SashaLag/Dorothy/ControlloMotori/Pololu - TB6612FNG Dual Motor Driver Carrier_files/0J4617.600x480.jpg

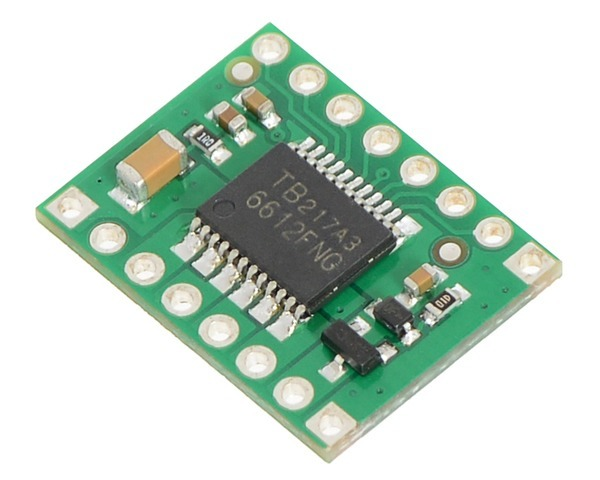
ControlloMotori/Pololu - TB6612FNG Dual Motor Driver Carrier_files/0J4617.600x480.jpg
