SashaLag/Dorothy/Report/Report Dorothy.pdf

## Progetto del veicolo a guida indoor autonoma Dorothy

Facoltà di Ingegneria dell’Informazione, Informatica e Statistica

Corso di Laurea Magistrale in Ingegneria Elettronica

Marco Balsi,

## Laboratorio II - Multidisciplinare

Alessandro Dei Giudici, 1398361 Pierpaolo Granello 1571747

Anno Accademico 2017/2018

Progetto del veicolo a guida indoor autonoma Dorothy

## Laboratotio Multidisciplinare II - Marco Balsi. Sapienza – Università di Roma

© 2018 Alessandro Dei Giudici, Pierpaolo Granello. Tutti i diritti riservati

Questa relazione è stata composta con LATEX e la classe Sapthesis.

Versione: 27 maggio 2018

Email dell’autore: deigiudici.1398361@studenti.uniroma1.it, granello.1571747@studenti.uniroma1.it

ii

# Indice

1 Introduzione | 1
2 Creazione delle specifiche | 2
3 List of Components | 6
4 Verifica e validazione | 13

1

# Capitolo 1

# Introduzione

Lo scopo del presente progetto è quello di simulare lo sviluppo di un veicolo a guida indoor autonoma in base alle specifiche fornite da un ipotetico committente. A partire dalle richieste espresse da quest’ultimo, in linguaggio poco tecnico e a volte parziale (User Needs), sono state formulate specifiche più tecniche e dettagliate (User Requirements). In questa fase, vengono elaborate le richieste dell’utente al fine di ottenere caratteristiche tecniche del dispositivo che l’utente può aver omesso o non considerato affatto; devono, di conseguenza, essere complete, chiare, tracciabili (deve esserci un collegamento chiaro tra esigenze e requisiti) e non ridondanti (non ce ne devono essere di più di quelli richieste).
Superata questa fase si passa allo sviluppo tecnico dove il committente non partecipa e per questo si redige una relazione sullo sviluppo delle specifiche tecniche e delle specifiche dei componenti. Le prime (System Specification) descrivono detta-gliamente il dispositivo che verrà progettato, le seconde (Component Specifications) descrivono le caratteristiche dei singoli componenti necessari per la realizzazione effettiva del prototipo. Entrambe le specifiche devono anche qui presentare gli stessi attributi di completezza, tracciabilità e non ridondanza come descritto in precedenza per gli User Requirements.
Al fine di verificare il rispetto delle specifiche stilate sono stati sviluppati dei codici di test (Verifica e validazione). L’ultima fase è stata quindi quella della realizzazione fisica del dispositivo.

2

# Capitolo 2

# Creazione delle specifiche

## 2.1 User Needs

Di seguito verranno riportate le specifiche richieste inizialmente dall’utente:

- UN1 - veicolo autonomo capace di navigare in un ambiente indoor sconosciuto
- UN2 - piccolo veicolo che si muove in modo autonomo scegliendo il percorso più libero in un raggio di 10m tenendo conto di oggetti anche piccoli a diverse altezze
- UN3 - se urta un ostacolo deve fermarsi
- UN4 - velocità media almeno 0.2m/s, autonomia almeno 10’
- UN5 - visualizzare su un terminale remoto le misure acquisite
- UN6 - il prezzo del sistema non deve eccedere 300€

## 2.2 User Requirements

A partire dalle specifiche comunicate dall’utente sono stati elaborati i seguenti requisiti:

- UR01 – veicolo di dimensioni massime non oltre i 25cm, capace di portare un carico (payload) di 100g, muovendosi su una superficie liscia in ambiente occupato da oggetti artificiali.
- UR02 – il veicolo deve esplorare l’ambiente percorrendo una direzione libera nei suoi dintorni, mantenendo la stessa direzione finché è possibile senza collidere con ostacoli, e cambiando direzione quando non può procedere oltre.
- UR03 – I sensori devono poter riconoscere la presenza di un ostacolo fino a 10m di distanza con una accuratezza trasversale di 5cm a 1m di distanza, valutandone la posizione verticale con accuratezza di 10cm
- UR04 – Il carrello deve potersi muovere in modo da mantenere una velocità media di almeno 0.2m/s

2.3 System Specification | 3
- UR05 – L’autonomia di funzionamento deve essere di almeno 10’
- UR06 – Trasferire le misure acquisite attraverso connessione senza fili verso un computer remoto per visualizzarle
- UR07 – In caso di urto frontale il veicolo deve fermarsi immediatamente e cercando un nuovo percorso libero come per la UR02
- UR08 – Il prezzo del sistema (con riferimento all’ordine di 1000 pezzi) non deve eccedere 300€

Di seguito si riporta la matrice di tracciabilità tra esigenze di utente e requisiti di sistema:

Tabella 2.1. Matrice di tracciabilità tra esigenze di utente e requisiti di utente

UN01 | UN02 | UN03 | UN04 | UN05 | UN06

UR01
UR02
UR03
UR04
UR05
UR06
UR07
UR08

## 2.3 System Specification

A partire dalle specifiche concordate con il cliente, sono state formulate le seguenti specifiche di sistema:

- SS01 - veicolo di diametro non oltre i 25cm, capace di portare un carico (payload) di 100g, muovendosi su una superficie liscia
- SS02 – il sistema di controllo utilizza osservazioni provenienti da opportuni sensori per determinare lo spazio libero per il movimento
- SS03 - il sistema di controllo muove il veicolo in direzione rettilinea per almeno 1m purché le misure ottenute dai sensori indichino che c’è spazio sufficiente coerentemente con il movimento programmato fino alla successiva lettura dei sensori stessi
- SS04 – se le misure ottenute dai sensori indicano che non c’è spazio sufficiente per proseguire nella stessa direzione, il sistema di controllo programma una rotazione di 45° e effettua un nuovo tentativo di procedere in avanti
- SS05 - In caso di ostacolo frontalmente, il veicolo compie una rotazione sul posto a passo di 45° con direzione decisa in base ai dati acquisiti precedentemente dal LiDAR ed esegue nuovamente la scansione. Se la ricerca fallisce per 8 volte consecutive (un giro completo), si arresta a meno di un segnale di reset.

2.3 System Specification | 4
- SS06 – I sensori devono poter osservare oggetti artificiali fino a 10 m di distanza
- SS07 – I sensori devono acquisire misure di distanza eseguendo un campiona-mento in azimuth con risoluzione angolare non eccedente 2.5° [atn(0.05/1)] nell’ambito di un angolo complessivo di 45°
- SS08 – I sensori devono acquisire misure di distanza eseguendo un campio-namento in elevazione con risoluzione angolare non eccedente 5° [atn(0.1/1)] nell’ambito di un angolo complessivo di 25°
- SS09 – Il veicolo deve poter mantenere una velocità media (su 30”) di almeno 0.2m/s, tenendo conto di eventuali fermate non superiori a 2", necessarie per l’osservazione dell’ambiente
- SS10 – Il veicolo deve essere dotato di un sensore di contatto frontale e il sistema di controllo deve reagire immediatamente in caso di contatto bloccando i motori fino a individuare un percorso libero coerentemente a SS05
- SS11 - Il sistema deve essere dotato di una connessione radio per dati capace di trasferire una quantità di misure pari a quelle acquisite in base a SS07 e SS08. Il computer remoto deve essere dotato di software per acquisizione e visualizzazione delle misure
- SS12 – Il sistema deve avere una riserva di energia sufficiente per 10’ di funzionamento
- SS13 – Il costo totale dei componenti non deve eccedere 150€

Tabella 2.2. Matrice di tracciabilità tra requisiti dell’utente e specifiche di sistema

UR01 | UR02 | UR03 | UR04 | UR05 | UR06 | UR07 | UR08

SS01
SS02
SS03
SS04
SS05
SS06
SS07
SS08
SS09
SS10
SS11
SS12
SS13

2.4 Component Specificications | 5

## 2.4 Component Specificications

A partire dalle specifiche di sistema sono state stilate le seguenti specifiche sui componenti acquistati:

- SC01 - veicolo di diametro non oltre i 25cm, capace di portare un carico (payload) di 100g, dotato di due ruote motrici più una libera oppure di due cingoli indipendenti, azionati da due motori elettrici in grado di garantire una velocità media di 0.2m/s
- SC02 - I sensori di contatto sono realizzati con 2 semplici switch in pulldown montati frontalmente al veicolo
- SC03 - Il sensore per ostacoli è costituito da un LiDAR, montato su una coppia di servo opportunamente articolati, e da due switch per l’arresto immediato del veicolo in caso di urto con un oggetto
- SC04 - La movimentazione del servo sul piano orizzontale prevede almeno 19 punti, spaziati di 2.5° da -22.5° a +22.5° rispetto alla direzione frontale
- SC05 - La movimentazione del servo sul piano verticale prevede almeno 6 punti, spaziati di 5° da 0° a +25° rispetto alla direzione frontale
- SC06 - Ad ogni sosta il LiDAR esegue una scansione completa (19x6 punti) e prende una decisione sul successivo spostamento del veicolo in meno di 2"
- SC07¹
- La connessione wireless è implementata utilizzando un trasmettitore ed un ricevitore radio funzionanti a 433 MHz.

Tabella 2.3. Matrice di tracciabilità tra specifiche dei componenti e specifiche di sistema

SC01 | SC02 | SC03 | SC04 | SC05 | SC06 | SC07

SS01
SS02
SS03
SS04
SS05
SS06
SS07
SS08
SS09
SS10
SS11
SS12
SS13

1
In seguito ad una succeccissiva discussione con l’utente in merito alla SC07, si è concordato di elidere la richiesta UN5, date le difficoltà della sua implementazione. Conseguentemente si trascura la specifica di sistema SS11 nella realizzazione del veicolo.

6

# Capitolo 3

# List of Components

Per la costruzione del veicolo progettato, il seguente è un elenco dei componenti necessari per la sua realizzazione:

- Arduino Uno R3,
- Kit Chassis 2 ruote,
- Driver PWM per motori Pololu - TB6612FNG,
- Benewake TFMINI Micro LiDAR Module (12 m),
- DFRobot DF05BB Tilt/Pan Kit (5kg),
- 433 MHz RF Transmitter and Receiver Kit,
- 2x Condensatori ELNA 2200 µF, 35V,
- 1x Condensatore Nichicon 33 µF, 35V,
- 4x Batterie AA NiMh,
- 1x Batteria 9V,
- 2x Switch Canal M140-T01.

## 3.1 Arduino Uno R3

Alla base del veicolo vi è Arduino/Genuino Uno R3, una scheda di sviluppo basata su microcontrollore ATMega368P prodotto da Atmel con architettura RISC funzionante a 16 Mhz. Questa offre 32KB di memoria flash, 2KB di SRAM, 1KB di EEPROM e 14 porte di I/O: 6 di queste porte I/O possiedono funzionalità PWM, altre 6 sono porte analogiche. La piattaforma Arduino è alimentata tramite una batteria da 9V utilizzato l’ingresso DCin che presenta un regolatore di tensione a 5V idoneo all’alimentazione del microcontrollore.
Si è scelto tale microcontrollore per il numero di porte disponibili, sufficienti a soddisfare le connessioni richieste, senza eccedere in dimensioni, peso, costo e consumo e senza allo stesso tempo andare in difetto in termini di potenza di calcolo.

3.2 Kit chassis | 7

Inoltre, è stato scelto per la semplicità di programmazione vista la disponibilità di librerie già scritte da terzi per l’interfacciamento dello stesso con le periferiche utilizzate, riducendo quindi i costi di ingegnerizzazione iniziale.

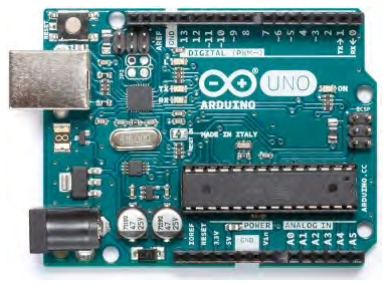
[picture p2: figure]

Figura 3.1. Arduino Mega 2560

## 3.2 Kit chassis

La struttura del veicolo è realizzata a partire dal seguente kit in plexiglass dedicato. Nel kit sono presenti due motori con relative ruote gommate pilotati indipendente dal microcontrollore e una terza ruota in plastica pivotante. Il vano batterie raffigurato fornisce i 6 Volt necessari per alimentare LiDAR, servomotori e motori.

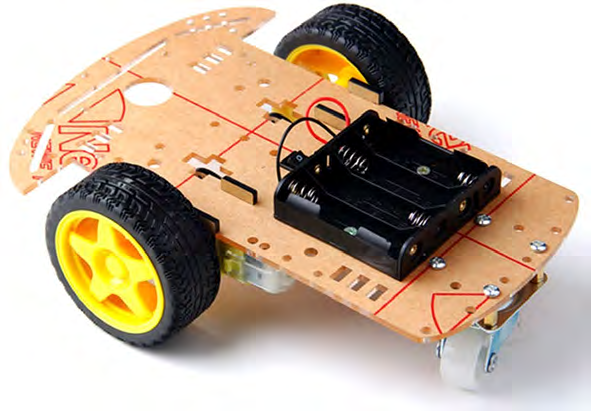
[picture p3: figure]

Figura 3.2. Kit chassis con 2 ruote

Si è scelto tale kit per il costo ridotto e la predisposizione parziale al montaggio dei vari componenti. Al fine di migliorare la distribuzione dei pesi, migliorare l’altezza di osservazione dei dispositivi di acquisizione e la loro mobilità, la struttura è stata comunque opportunatamente modificata.

3.3 Driver PWM per motori Pololu - TB6612FNG | 8

## 3.3 Driver PWM per motori Pololu - TB6612FNG

A causa dell’elevato assorbimento di corrente da parte dei motori, non è possibile pilotarli direttamente dai pin PWM di Arduino in quanto la corrente richiesta è superiore a quella massima dichiarata nell’electrical datasheet del microcontrollore. Si è perciò interposto l’integrato TB6612FNG di Pololu.

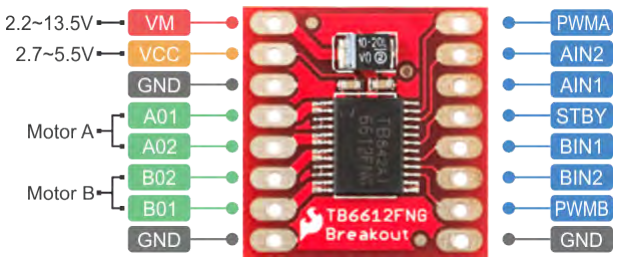
[picture p4: figure]

Figura 3.3. Driver ponte H TB6612FNG di Pololu

Si è scelto tale driver per la sua facile reperebilità e capacità di pilotare due motori indipendentemente con quattro modalità di funzionamento: clockwise, counter clockwise, short brake e stop mode. Il driver è capace erogare 1.2 Ampere con picchi di 3.2 Ampere, pienamente in grado quindi di pilotare le correnti richieste dai motori utilizzati (assorbimento massimo pari a 0.8 Ampere). Presenta inoltre un circuito di protezione rispetto a temperatura e cortocircuito.

## 3.4 Benewake TFMINI Micro LiDAR Module (12 m)

Per la ricostruzione dell’ambiente circostante al veicolo si è scelto il LiDAR TFMini Micro, prodotto da Benewake. Questo dispositivo è in grado di acquisire i dati fino ad una distanza massima di 12 metri e si collega con il microcontrollore tramite interfaccia UART. Per stabilizzare l’alimentazione durante l’acquisizione e la tra-smissione dei dati è stata posta una capacità in parallelo all’alimentazione da 33 µF, 35 V prodotti da Nichicon.

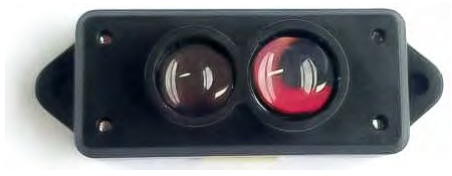
[picture p5: figure]

Figura 3.4. Modulo LiDAR Benewake TFMINI

Si è scelto questo modello per costo, peso e dimensioni ridotti, oltre che per il basso consumo e la possibilità di condividere l’alimentazione con il resto del sistema.

3.5 DFRobot DF05BB Tilt/Pan Kit (5kg) | 9

## 3.5 DFRobot DF05BB Tilt/Pan Kit (5kg)

Per la scansione dell’amnbiente circostante il LiDAR è stato montato sul presente kit composto da due servomotori DF05BB di DFRobot: uno dedicato al movimento verticale (Tilt) e l’altro al movimento orizzonatale (Pan). Per disaccoppiare i picchi d’assorbimento di corrente durante il movimento degli stessi è stata posta per ciascuno una capacità in parallelo da 2200 µF, 35 V prodotti da ELNA.

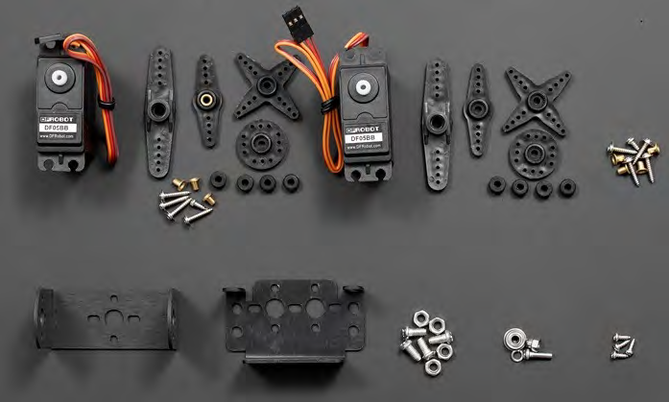
[picture p6: figure]

Figura 3.5. Modulo LiDAR Benewake TFMINI

I motori sono controllati tramite PWM da Arduino. Si è scelto questo kit per il basso costo e la rapidità di montaggio.

## 3.6 Switch Canal M140-T01

Per le gestione degli urti frontali si è utilizzato una coppia di switch Canal M140-T01. Alla base di questa scelta, la semplice reperibilità. Gli switch sono stati collegati al microcontrollore in configurazione pulldown come in figura 3.7 per non avere consumo di corrente staticamente. In caso di urto gli switch chiudono il circuito verso massa generando una variazione dell’ingresso che verrà gestita dal microcontrollore come un interrupt.

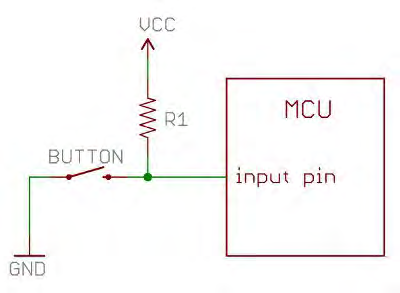
[picture p7: figure]
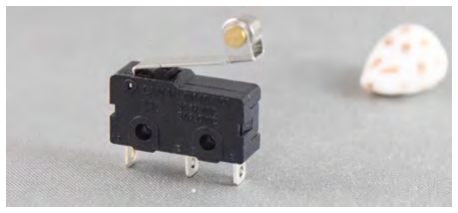
[picture p8: figure]

Figura 3.6. Switch Canal M140-T01 | Figura 3.7. Switch PullDown

3.7 Assemblaggio finale | 10

La resistenza R1 è dimensionata al fine di consumare la minore corrente possibile durante il periodo di chiusura. Volendo fissare la corrente a 1 milliAmpere , ed essendo l’alimentazione a 5 Volt si ottiene una resistenza pari a 5 kΩ.

## 3.7 Assemblaggio finale

Il veicolo è costituito da uno chassis in plexiglass dove sono montati direttamente i motori e i servo del LiDAR. E’ presente un supporto rialzato in plastica nel lato posteriore dove sono stati fissati la scheda Arduino Uno e il driver dei motori. Anteriormente sono stati posti i due switch che cortocircuitano a massa in caso di contatto frontale fisico con un ostacolo generando un evento di interrupt sul microcontrollore. Il vano da 4 batterie AA alimenta il driver dei motori e i servomotori ed è posto sul lato inferiore della chassis. La batteria da 9V alimenta Arduino tramite il regalatore di tensione integrato che alimenta anche il LiDAR montato in posizione frontale. Le due capacità poste frontalmente, come precedentemente descritto, stabilizzano l’alimentazione a fronte dei picchi di corrente richiesti dai servomotori. In figura 3.8 è riportato lo schema dei collegamenti elettrici del veicolo, mentre successivamente sono riportate alcune foto del prototipo realizzato:

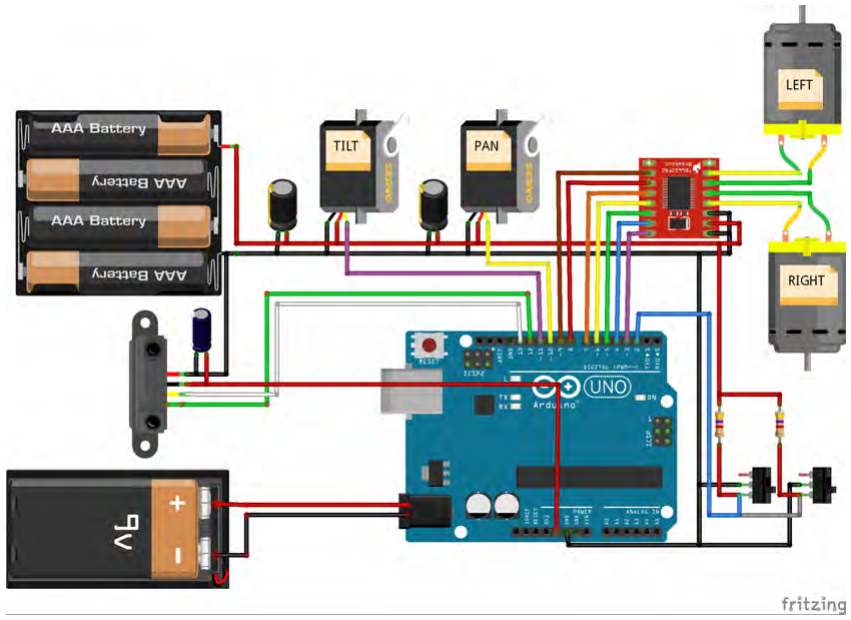
[picture p9: figure]

Figura 3.8. Schematico dei collegamenti del veicolo

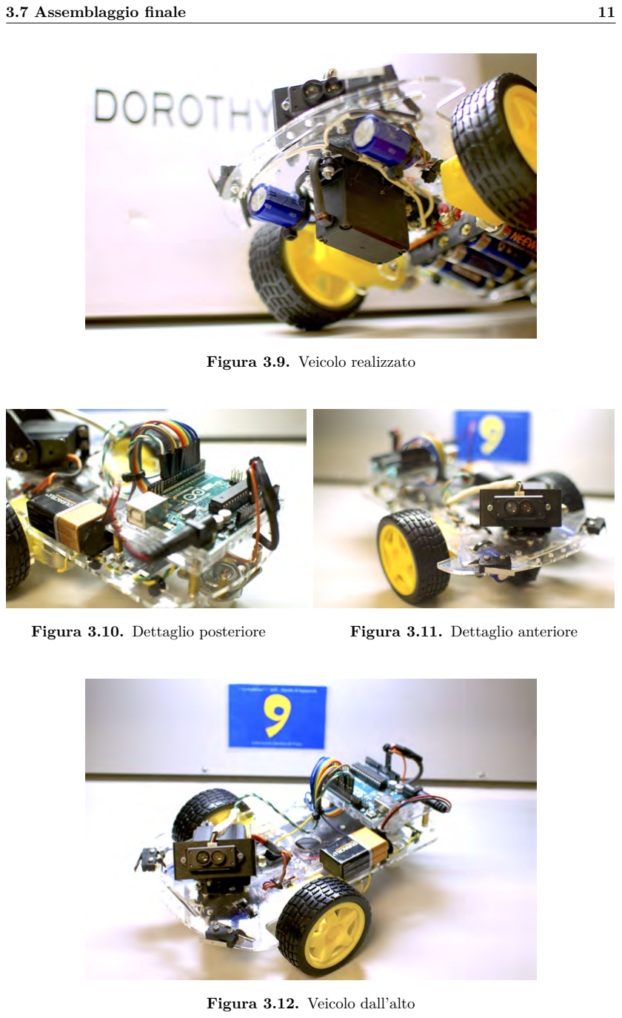
[picture p10: page 14]

3.7 Assemblaggio finale | 11

Figura 3.9. Veicolo realizzato

Figura 3.10. Dettaglio posteriore | Figura 3.11. Dettaglio anteriore

Figura 3.12. Veicolo dall’alto

3.8 Bill of Materials | 12

## 3.8 Bill of Materials

Il costo dei componenti utilizzati viene riportato nella seguente tabella:

Tabella 3.1. Matrice di tracciabilità tra esigenze di utente e requisiti di utente

# | Componente | Prezzo² | Venditore

1 | Arduino Uno R3 | 20.00€ | Arduino.cc
1 | Kit Chassis 2 ruote | 10,90€ | ebay
1 | Driver Pololu - TB6612FNG | 4.82€ | robotshop
1 | Benewake TFMINI Micro LiDAR | 38.40€ | robotshop
1 | DFRobot DF05BB Tilt/Pan Kit (5kg) | 28.34€ | robotshop
1 | 433 MHz RF TX & RX Kit | 2,40€ | ittgroup
2 | Condensatori ELNA 2200 µF, 35V | 0.28€ | Mouser
1 | Condensatore Nichicon 33 µF, 35V | 0.04€ | Mouser
4 | Batterie AA NiMh | 0.42€ | Mouser
1 | Batteria 9V | 1.02€ | Mouser
2 | Switch | 0.10€ | Mouser
30 | Jumper | 0.63€ | Farnell
| TOTALE | 107.37€

In seguito alla valutazione del costo totale, la specifica di sistema SS13 risulta verificata.

2
I prezzi considerati sono riferiti ad un ordine di almeno 1000 pezzi.

13

# Capitolo 4

# Verifica e validazione

I seguenti test sono stati eseguiti sui singoli componenti per verificarne il loro corretto funzionamento dopo averne controllato il corretto collegamento tramite la modalità "Continuity Test mode" del multimetro.

## 4.1 TS01: verifica della specifica di sistema SS01

- Setup di verifica: Veicolo posizionato su una superficie liscia con sufficiente spazio per consentire il movimento libero. Payload di 200 grammi posizionato centralmente sul veicolo.
- Esecuzione del test: Le dimensioni del veicolo sono state misurate con un metro. Successivamente il veicolo è stato fatto muovere con un firmware appositamente realizzato.
- Criterio di successo: Se il diametro misurato risulta essere minore o uguale a 25 centimetri e le ruote si muovono in modo coerente con quanto programmato, nonostante l’aggiunta del payload, il test ha esito positivo.
- Osservazioni: Il diametro misurato risulta essere pari a 24 centimetri e il movimento risulta fluido nonostante la presenza del payload. La specifica SS01 è verificata.

## 4.2 TS02: verifica delle specifiche di sistema SS02, SS06

- Setup di verifica: Veicolo con firmware LiDAR ed oggetto con distanza frontale dal LiDAR variata durante il test.
- Esecuzione del test: La distanza dell’oggetto mosso durante il test viene rilevata tramite porta seriale.
- Criterio di successo: Se la distanza misurata è coerente con quella reale, il test ha esito positivo.
- Osservazioni: Le misure rilevate risultano coerenti nel range di distanze compreso tra 0,2 e 12 metri. Le specifiche SS02 e SS06 risultano verificate.

4.3 TS03: verifica delle specifiche di sistema SS03, SS04, SS05 | 14

4.3 TS03: verifica delle specifiche di sistema SS03, SS04, SS05

- Setup di verifica: Veicolo posto in un ambiente di test con firmware Servo (in appendice).
- Esecuzione del test: Ambiente inizialmente libero e successivamente occupato da ostacoli posti frontalmente al veicolo.
- Criterio di successo: Nel caso in cui il veicolo non rilevi ostacoli lungo il percorso e percorra un metro di distanza in rettilineo, oppure, in caso contrario, ruoti a passi di 45° fino a trovarne uno libero (per un numero massimo di 8 tentativi, altrimenti si arresta), il test ha esito positivo.
- Osservazioni: Il comportamento del veicolo risulta coerente con quanto richiesto. Le specifiche SS03, SS04 e SS05 risultano verificate.

## 4.4 TS04: verifica delle specifiche di sistema SS07, SS08

- Setup di verifica: Veicolo alimentato posto in un ambiente di test con firmware specifico.
- Esecuzione del test: Avvio di una routine in ambiente Processing. La routine plotta su un grafico i punti acquisiti dal LiDAR e ricevuti dal PC tramite collegamento con porta seriale.
- Criterio di successo: Se il dispositivo acquisisce correttamente i valori delle distanze degli oggetti posti frontalmente al veicolo, effettuando 19 scansioni orizzontali in combinazione a 6 scansioni orizzontali, il test ha esito positivo.
- Osservazioni: Il comportamento dei servomotori accoppiato a quello del LiDAR risulta coerente con quanto richiesto. Le specifiche SS07 e SS08 risultano verificate.

## 4.5 TS05: verifica della specifica di sistema SS09

- Setup di verifica: Veicolo alimentato posto in un ambiente di test con firmware finale.
- Esecuzione del test: Tramite misura della distanza percorsa in un determi-nato intervallo temporale, viene determinata la velocità media del dispositivo durante il regolare funzionamento.
- Criterio di successo: Se la velocità media del dispositivo risulta essere pari a 0.2 m/s, tenendo conto di eventuali fermate non superiori a 2", il test ha esito positivo.
- Osservazioni: Il comportamento del veicolo risulta coerente con quanto richiesto. La specifica SS09 risulta verificata.

4.6 TS06: verifica della specifica di sistema SS10 | 15

## 4.6 TS06: verifica della specifica di sistema SS10

- Setup di verifica: Veicolo alimentato posto in un ambiente di test con firmware Interrupt (in appendice).
- Esecuzione del test: Il veicolo è posto su una superficie piana con ruote rial-zate. L’esecuzione del firmware comanda un movimento continuo di entrambe le ruote a velocità costante.
- Criterio di successo: Se all’azionamento individuale o contemporaneo degli switch posti frontalmente al veicolo la rotazione delle ruote si arresta, il test ha esito positivo.
- Osservazioni: Il comportamento dei sensori di contatto frontali risulta coerente con quanto richiesto. La specifica SS10 risulta verificata.

## 4.7 TS07: verifica della specifica di sistema SS12

- Setup di verifica: Veicolo posto in un ambiente di test con firmware finale.
- Esecuzione del test: Il veicolo viene fatto funzionare senza interruzioni per 10’. Sono simulate più condizioni con batterie ogni volta alla massima carica:

– il veicolo trova sempre almeno un percorso libero,
– il veicolo urta un ostacolo e rimane in situazione di arresto,
– il veicolo non riesce a trovare alcuna direzione libera e va in idle,

Per ogni test viene misurata l’autonomia massima del dispositivo.

- Criterio di successo: Se il veicolo, per ognuna delle condizioni descritte, riesce ad avere autonomia maggiore di 10’ il test ha esito positivo.
- Osservazioni: La specifica SS12 sull’autonomia risulta verificata.

Tabella 4.1. Matrice di tracciabilità tra requisiti dell’utente e specifiche di sistema

TS01 | TS02 | TS03 | TS04 | TS05 | TS06 | TS07 | BoM

SS01
SS02
SS03
SS04
SS05
SS06
SS07
SS08
SS09
SS10
SS11
SS12
SS13

16

# Appendice

## Codice per test dei componenti

Test Lidar

1 #include <S o f t w a r e S e r i a l . h>
2 #include " TFMini . h "

3
4 | //Uno RX (TFMINI TX) , Uno TX (TFMINI RX)
5 | S o f t w a r e S e r i a l m ySe ri al ( 1 2 , 1 3 ) ;
6 TFMini t fmi ni ;

7
8 | void se tup ( ) {
9 | S e r i a l . b e gi n ( 1 1 5 2 0 0 ) ;
10 | while ( ! S e r i a l ) ;
11 | S e r i a l . p r i n t l n ( " I n i t i a l i z i n g . . . " ) ;
12 | m ySe ri al . b e gi n (TFMINI_BAUDRATE) ;
13 | t fmi ni . be gi n (&m ySe ri al ) ;
14 | }

15
16 | void l o o p ( ) {
17 | uin t16_ t d i s t = t fmi ni . g e tDi s t a n c e ( ) ;
18 | S e r i a l . p ri n t ( d i s t ) ;
19 | S e r i a l . p ri n t ( " ␣cm␣␣ ␣ ␣ ␣ ␣ " ) ;
20 | //Wait some t ime b e f o r e n e x t measurement
21 | d el a y ( 2 5 ) ;
22 | }

Test Servo

1 #include <Servo . h>

2
3 #def ine Min_Tilt | 46 | // T i l t −12.5 d e g r e e
4 #def ine Mid_Tilt | 50 | // Servo Mid P o s i t i o n
5 #def ine Max_Tilt | 71 | // T i l t +12.5 d e g r e e
6 #def ine Min_Pan | 4 7. 5 | //Pan −22.5 d e g r e e
7 #def ine Mid_Pan | 75 | // Servo Mid P o s i t i o n
8 #def ine Max_Pan | 9 2. 5 | //Pan +22.5 d e g r e e

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

23
24 | void Pan_Flow ( ) {
25 | i f ( x s c a n Di r e c ti o n == 0 ) {
26 | for ( xpos = Min_Pan ; xpos <= Max_Pan; xpos += 2 . 5 ) {
27 | PAN. w ri t e ( xpos ) ; | // go t o p o s i t i o n in v a r i a b l e ’ pos ’
28 | d el a y ( 3 0 ) ;
29 | Tilt_Flow ( ) ;
30 | y s c a n Di r e c ti o n = ~ y s c a n Di r e c ti o n ;
31 | }
32 | }
33 | e l s e {
34 | for ( xpos = Max_Pan; xpos >= Min_Pan ; xpos −= 2 . 5 ) {
35 | PAN. w ri t e ( xpos ) ; | // go t o p o s i t i o n in v a r i a b l e ’ pos ’
36 | d el a y ( 3 0 ) ;
37 | Tilt_Flow ( ) ;
38 | y s c a n Di r e c ti o n = ~ y s c a n Di r e c ti o n ;
39 | }
40 | }
41 | x s c a n Di r e c ti o n = ~ x s c a n Di r e c ti o n ;
42 | }

43
44 | void Tilt_Flow ( ) {
45 | i f ( y s c a n Di r e c ti o n == 0 ) {
46 | for ( ypos = Min_Tilt ; ypos <= Max_Tilt ; ypos += 5 ) {
47 | TILT . w ri t e ( ypos ) ; | // go t o p o s i t i o n in v a r i a b l e ’ pos ’
48 | d el a y ( 3 0 ) ;
49 | }
50 | }
51 | e l s e {
52 | for ( ypos = Max_Tilt ; ypos >= Min_Tilt ; ypos −= 5 ) {
53 | TILT . w ri t e ( ypos ) ; | // go t o p o s i t i o n in v a r i a b l e ’ pos ’
54 | d el a y ( 3 0 ) ;
55 | }
56 | }
57 | }

58
59 | void l o o p ( ) {
60 | Pan_Flow ( ) ;
61 | d el a y ( 1 5 0 ) ;
62 | }

4.7 TS07: verifica della specifica di sistema SS12 | 18

Test Motori

1 #include <SparkFun_TB6612 . h>

2
3 #def ine AIN1 2
4 #def ine BIN1 7
5 #def ine AIN2 4
6 #def ine BIN2 8
7 #def ine PWMA 5
8 #def ine PWMB 6
9 #def ine STBY 9

10
11 | const int o f f s e t A = 1 ;
12 | const int o f f s e t B = 1 ;
13 | Motor motor1 = Motor (AIN1 , AIN2 , PWMA, o f f s e tA , STBY) ;
14 | Motor motor2 = Motor ( BIN1 , BIN2 , PWMB, o f f s e t B , STBY) ;

15
16 | void se tup ( ) {
17 | }

18
19
20 | void l o o p ( ) {
21 | motor1 . d ri v e ( 2 5 5 , 1 0 0 0 ) ;
22 | motor1 . d ri v e ( −255 ,1000) ;
23 | motor1 . brake ( ) ;
24 | d el a y ( 1 0 0 0 ) ;

25
26 | motor2 . d ri v e ( 2 5 5 , 1 0 0 0 ) ;
27 | motor2 . d ri v e ( −255 ,1000) ;
28 | motor2 . brake ( ) ;
29 | d el a y ( 1 0 0 0 ) ;

30
31 | f o rw a rd ( motor1 , motor2 , 1 5 0 ) ;
32 | d el a y ( 1 0 0 0 ) ;

33
34 | back ( motor1 , motor2 , −150) ;
35 | d el a y ( 1 0 0 0 ) ;

36
37 | brake ( motor1 , motor2 ) ;
38 | d el a y ( 1 0 0 0 ) ;

39
40 | l e f t ( motor1 , motor2 , 1 0 0 ) ;
41 | d el a y ( 1 0 0 0 ) ;
42 | r i g h t ( motor1 , motor2 , 1 0 0 ) ;
43 | d el a y ( 1 0 0 0 ) ;

44
45 | brake ( motor1 , motor2 ) ;
46 | d el a y ( 1 0 0 0 ) ; | l
47 | }

4.7 TS07: verifica della specifica di sistema SS12 | 19

Test Interrupt

1 #include <SparkFun_TB6612 . h> // Con ta ins t h e c l a s s Motor

2
3 | // P ins f o r a l l i n p u t s , PWM d e f i n e s must be on PWM p i n s
4 #def ine AIN1 5 | // 2 Verde
5 #def ine BIN1 7 | // 7 Aranc ione
6 #def ine AIN2 4 | // 4 Blu
7 #def ine BIN2 8 | // 8 Rosso
8 #def ine PWMA 3 | // 5 V i ol a
9 #def ine PWMB 11 // 6 Marrone
10 #def ine STBY 6 | // | G i a l l o

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

16
17 | void STOP( ) {
18 | brake (LEFT, RIGHT) ;
19 | }

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

24
25 | void l o o p ( ) {
26 | f o rw a rd (LEFT, RIGHT, 5 0 ) ;
27 | d el a y ( 5 0 0 0 ) ;
28 | }

4.7 TS07: verifica della specifica di sistema SS12 | 20

## Firmware

Dorothy.ino

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

9
10 #include <S o f t w a r e S e r i a l . h>
11 #include "PWMServo. h "
12 #include " TFMini . h "
13 #include <SparkFun_TB6612 . h> // Con ta ins t h e c l a s s Motor 14 #include <avr / power . h>

15
16 #def ine Min_Tilt | 50 | // T i l t −12.5 d e g r e e
17 #def ine Mid_Tilt | 6 2. 5 | // Servo Mid P o s i t i o n
18 #def ine Max_Tilt | 75 | // T i l t +12.5 d e g r e e

19
20 #def ine Min_Pan | 5 2. 5 | //Pan −22.5 d e g r e e
21 #def ine Mid_Pan | 75 | // Servo Mid P o s i t i o n
22 #def ine Max_Pan | 9 7. 5 | //Pan +22.5 d e g r e e

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

27
28 | // P ins f o r a l l i n p u t s , PWM d e f i n e s must be on PWM p i n s
29 #def ine AIN1 5 | // 2 Verde
30 #def ine BIN1 7 | // 7 Aranc ione
31 #def ine AIN2 4 | // 4 Blu
32 #def ine BIN2 8 | // 8 Rosso
33 #def ine PWMA 3 | // 5 V i ol a
34 #def ine PWMB 11 // 6 Marrone
35 #def ine STBY 6 | // | G i a l l o

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

4.7 TS07: verifica della specifica di sistema SS12 | 21
50 | // A l l o c a t i n g Memory f o r LIDAR r e s u l t s
51 | int ∗LiDAR_Radius = m all oc ( Iter_Pan ∗ s i z e o f ( uin t16_ t ∗) ) ;

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

63
64 | // Func t i on s
65 | void Pan_Flow ( ) ;
66 | void Tilt_Flow ( ) ;
67 | void l i d a r _ a c q u i s i t i o n ( ) ;
68 | // v o i d p r i n tM a t r i x ( ) ;
69 | int C h o o s eDi r e c ti o n ( ) ;
70 | void Ch an geDi rec ti on ( ) ;
71 | void STOP( ) ;

72
73
74 | void se tup ( ) {
75 | a t t a c h I n t e r r u p t ( di g i t a l P i n T o I n t e r r u p t ( 2 ) , STOP, LOW) ;
76 | PAN. a t t a c h (SERVO_PIN_A) ; | // G i a l l o
77 | TILT . a t t a c h (SERVO_PIN_B) ; | // V i ol a
78 | PAN. w ri t e (Min_Pan ) ;
79 | TILT . w ri t e ( Min_Tilt ) ;

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

87
88 | void l o o p ( ) {
89 | while ( s e a r c h < 8 ) {
90 | for ( int i =0; i<Iter_Pan ; ++i ) {
91 | LiDAR_Radius [ i ] = 1 0 0;
92 | }
93 | Pan_Flow ( ) ; | // Servo and L i d ar a c t i o n s

94
95 | i f ( C h o o s eDi r e c ti o n ( ) ==1){ | // Go S t r a i g h t
96 | s e a r c h = 0 ;
97 | f o rw a rd (LEFT,RIGHT, 1 0 0 ) ;
98 | d el a y ( 1 5 0 0 ) ;
99 | brake (LEFT, RIGHT) ;
100 | }
101 | e l s e {
102 | Ch an geDi rec ti on ( ) ;

4.7 TS07: verifica della specifica di sistema SS12 | 22
103 | }
104 | }
105 | power_adc_disable ( ) ;
106 | p owe r_ spi_di s able ( ) ;
107 | power_ timer0_disable ( ) ;
108 | power_ timer1_disable ( ) ;
109 | power_ timer2_disable ( ) ;
110 | power_twi_disable ( ) ;
111 | }

Functions.ino

1 | void Pan_Flow ( ) {
2 | i f ( x s c a n Di r e c ti o n == 0 ) {
3 | for ( xpos=Min_Pan , xPan=0; xpos<=Max_Pan; xpos+=2.5,++xPan ) {
4 | PAN. w ri t e ( xpos ) ; | // go t o p o s i t i o n in v a r i a b l e ’ pos ’
5 | d el a y ( 5 ) ;
6 | Tilt_Flow ( ) ;
7 | y s c a n Di r e c ti o n = ~ y s c a n Di r e c ti o n ;
8 | }
9 | }
10 | e l s e {
11 | for ( xpos=Max_Pan, xPan=Iter_Pan −1; xpos>=Min_Pan ; xpos −=2.5,−−
| xPan ) {
12 | PAN. w ri t e ( xpos ) ; | // go t o p o s i t i o n in v a r i a b l e ’ pos ’
13 | d el a y ( 5 ) ;
14 | Tilt_Flow ( ) ;
15 | y s c a n Di r e c ti o n = ~ y s c a n Di r e c ti o n ;
16 | }
17 | }
18 | x s c a n Di r e c ti o n = ~ x s c a n Di r e c ti o n ;
19 | }

20
21
22 | void Tilt_Flow ( ) {
23 | i f ( y s c a n Di r e c ti o n == 0 ) {
24 | for ( ypos = Min_Tilt ; ypos <= Max_Tilt ; ypos += 5 ) {
25 | TILT . w ri t e ( ypos ) ; | // go t o p o s i t i o n in v a r i a b l e ’ pos ’
26 | d el a y ( 5 ) ;
27 | l i d a r _ a c q u i s i t i o n ( ) ;
28 | }
29 | }
30 | e l s e {
31 | for ( ypos = Max_Tilt ; ypos >= Min_Tilt ; ypos −= 5 ) {
32 | TILT . w ri t e ( ypos ) ; | // go t o p o s i t i o n in v a r i a b l e ’ pos ’
33 | d el a y ( 5 ) ;
34 | l i d a r _ a c q u i s i t i o n ( ) ;
35 | }
36 | }
37 | }

4.7 TS07: verifica della specifica di sistema SS12 | 23

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

50
51 | d el a y ( 1 0 ) ; | // L i d ar A c q u i s i t i o n Delay . No Movement can be done
52 | }

53
54
55 | int C h o o s eDi r e c ti o n ( ) {
56 | for ( int i =0; i<Iter_Pan ; ++i ) {
57 | i f ( LiDAR_Radius [ i ] < 1 0 0 ) {
58 | ++s e a r c h ;
59 | return 0 ;
60 | }
61 | e l s e return 1 ;
62 | }
63 | }

64
65
66 | void Ch an geDi rec ti on ( ) {
67 | LEFT. d ri v e ( 1 2 0 ) ;
68 | RIGHT. d ri v e (−120) ;
69 | d el a y ( 2 8 0 ) ;
70 | brake (LEFT, RIGHT) ;
71 | }

72
73
74 | void STOP( ) {
75 | brake (LEFT,RIGHT) ;
76 | }
