SashaLag/Dorothy/MotorTestRun/MotorTestRun.ino

#include <SparkFun_TB6612.h>

#define AIN1 2
#define BIN1 7
#define AIN2 4
#define BIN2 8
#define PWMA 5
#define PWMB 6
#define STBY 9

const int offsetA = 1;
const int offsetB = 1;
Motor motor1 = Motor(AIN1, AIN2, PWMA, offsetA, STBY);
Motor motor2 = Motor(BIN1, BIN2, PWMB, offsetB, STBY);

void setup() {
}


void loop() {
   motor1.drive(255,1000);
   motor1.drive(-255,1000);
   motor1.brake();
   delay(1000);
   
   motor2.drive(255,1000);
   motor2.drive(-255,1000);
   motor2.brake();
   delay(1000);
   
   forward(motor1, motor2, 150);
   delay(1000);

   back(motor1, motor2, -150);
   delay(1000);

   brake(motor1, motor2);
   delay(1000);

   left(motor1, motor2, 100);
   delay(1000);
   right(motor1, motor2, 100);
   delay(1000);
   
   brake(motor1, motor2);
   delay(1000);   l
}
